usimd/rpi-cm4-homeassistant-base/rpi-cm-ssd.kicad_pcb

## KiCad design rpi-cm-ssd.kicad_pcb (2025-02-02)

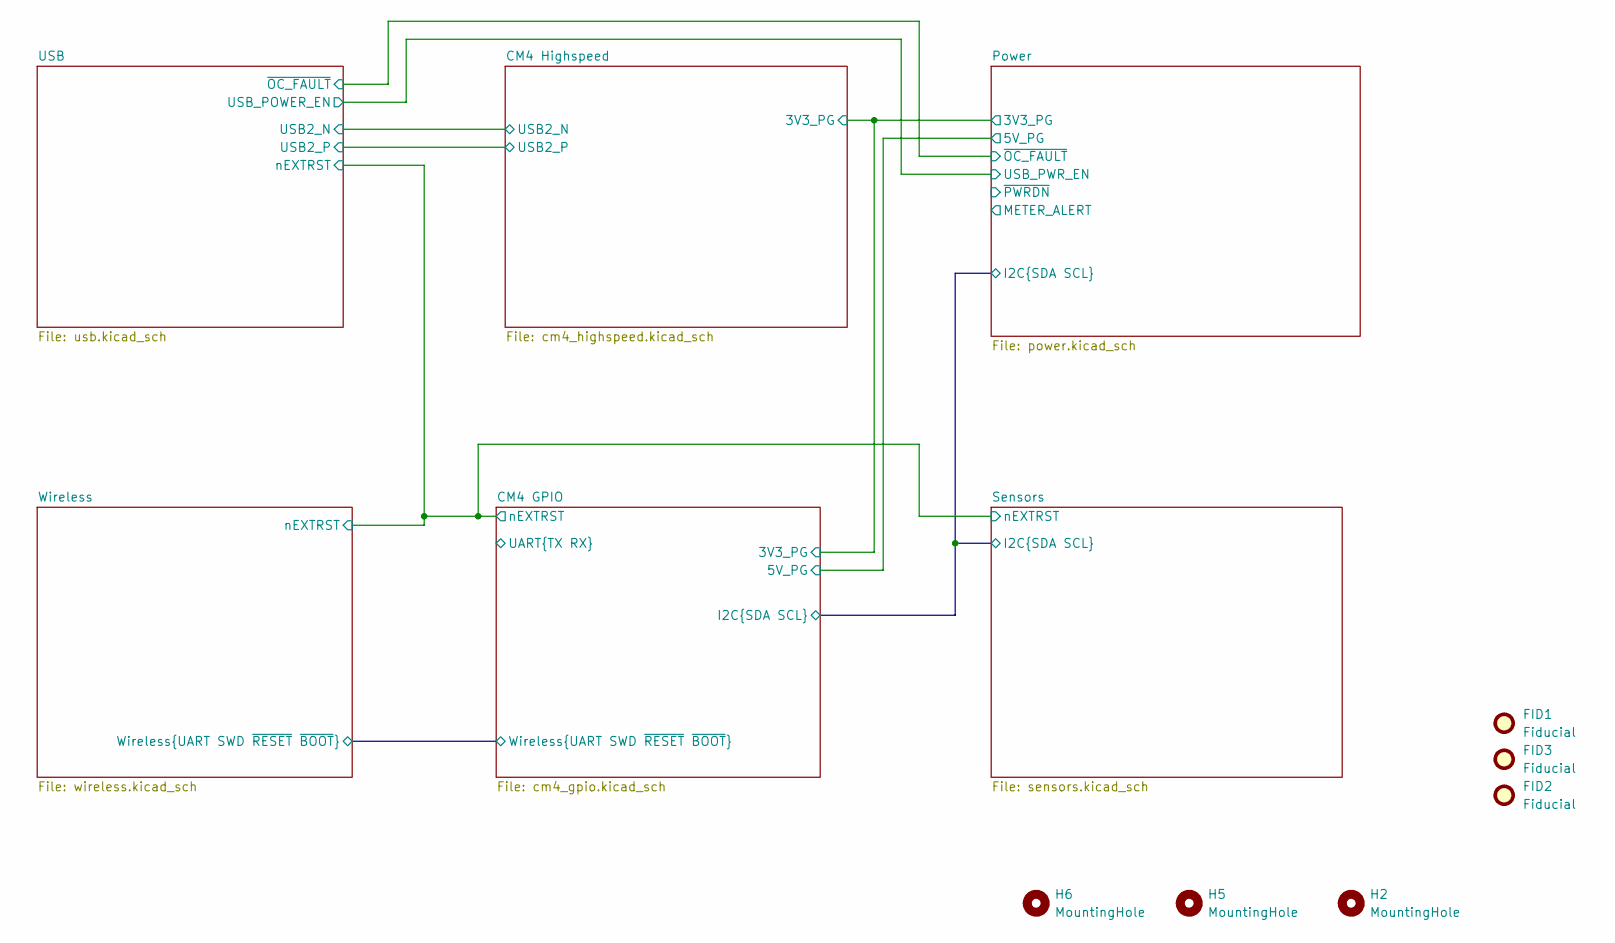
[picture p3: schematic rpi-cm-ssd.kicad_sch, Custom Homeassistant Base]

Parts:
FID1, FID2, FID3: Fiducial; Fiducial_0.5mm_Mask1mm
H2, H5, H6: MountingHole; MountingHole_2.7mm_M2.5; MPN KFS2-M2.5

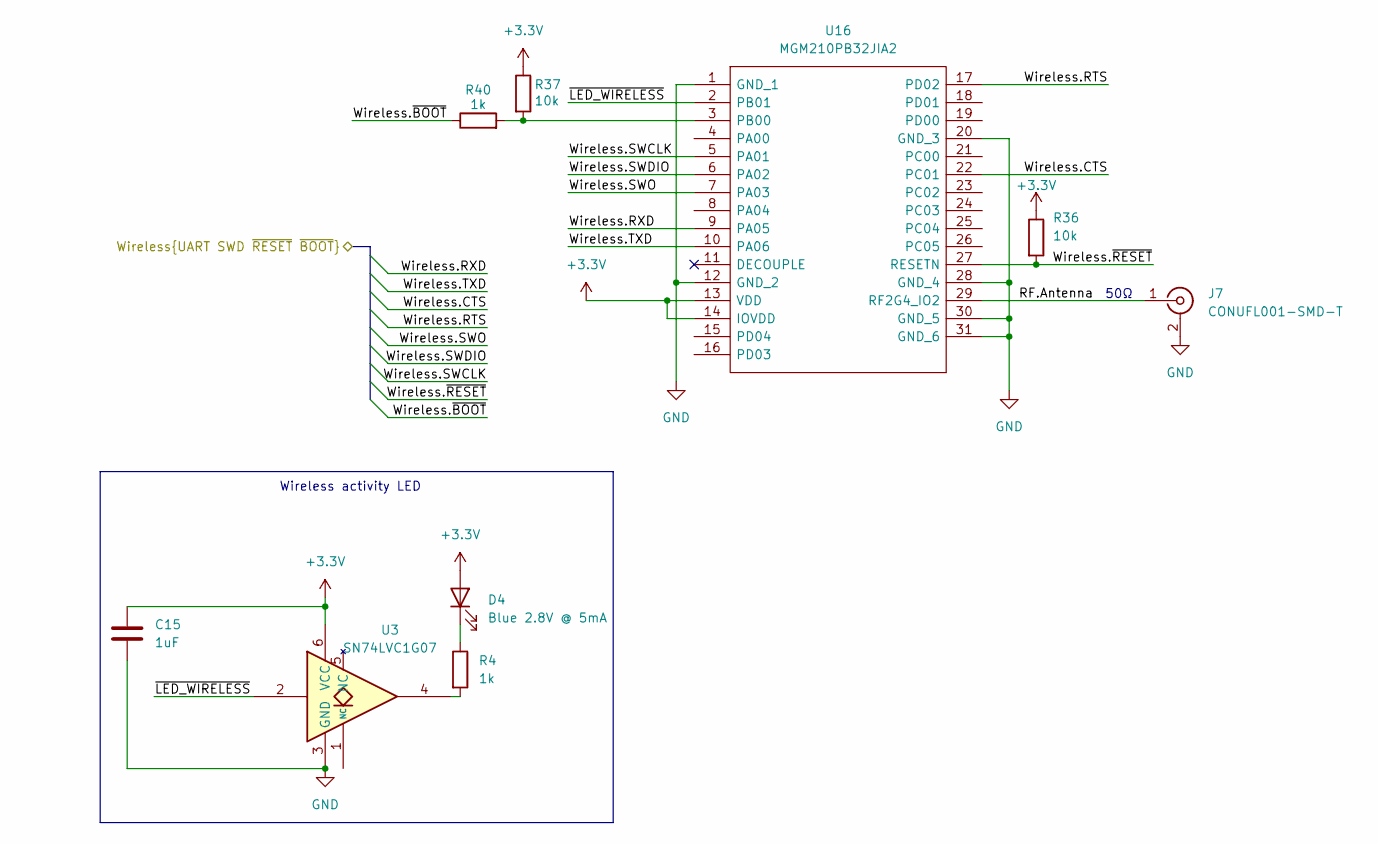
[picture p4: schematic wireless.kicad_sch]

Parts:
C15: 1uF; C_0402_1005Metric
D4: Blue 2.8V @ 5mA; LED_0603_1608Metric; MPN XL-1608UBC-04; LCSC Part # C965807
J7: CONUFL001-SMD-T; U.FL_Hirose_U.FL-R-SMT-1_Vertical; MPN CONUFL001-SMD-T; LCSC Part # C22418213
R4: 1k; R_0402_1005Metric
R36, R37: 10k; R_0603_1608Metric
R40: 1k; R_0603_1608Metric
U3: SN74LVC1G07; Texas_USON-6_1x1.45mm_P0.5mm_SMD; MPN SN74LVC1G07DRY; LCSC Part # C2675513
U16: MGM210PB32JIA2; MGM210PA32JIA2; Manufacturer_Part_Number MGM210PB32JIA2; Mouser Part Number 634-MGM210PB32JIA2

Connections:
+3.3V: C15.1, D4.2 (A), R36.1, R37.1, U3.6 (VCC), U16.13 (VDD), U16.14 (IOVDD); also elsewhere on the board
/CM4 GPIO/Wireless.CTS: U16.22 (PC01); also elsewhere on the board
/CM4 GPIO/Wireless.RTS: U16.17 (PD02); also elsewhere on the board
/CM4 GPIO/Wireless.RXD: U16.9 (PA05); also elsewhere on the board
/CM4 GPIO/Wireless.SWCLK: U16.5 (PA01); also elsewhere on the board
/CM4 GPIO/Wireless.SWDIO: U16.6 (PA02); also elsewhere on the board
/CM4 GPIO/Wireless.SWO: U16.7 (PA03)
/CM4 GPIO/Wireless.TXD: U16.10 (PA06); also elsewhere on the board
/CM4 GPIO/Wireless.~BOOT: R40.1; also elsewhere on the board
/CM4 GPIO/Wireless.~RESET: R36.2, U16.27 (RESETN); also elsewhere on the board
/Wireless/RF.Antenna: J7.1 (In), U16.29 (RF2G4_IO2)
/Wireless/~LED_WIRELESS: U3.2, U16.2 (PB01)
GND: C15.2, J7.2 (Ext), U3.3 (GND), U16.1 (GND_1), U16.12 (GND_2), U16.20 (GND_3), U16.28 (GND_4), U16.30 (GND_5), U16.31 (GND_6); also elsewhere on the board
unnamed: D4.1 (K), R4.1
unnamed: R4.2, U3.4
unnamed: R37.2, R40.2, U16.3 (PB00)

Notes on the sheet:
50Ω
Wireless activity LED

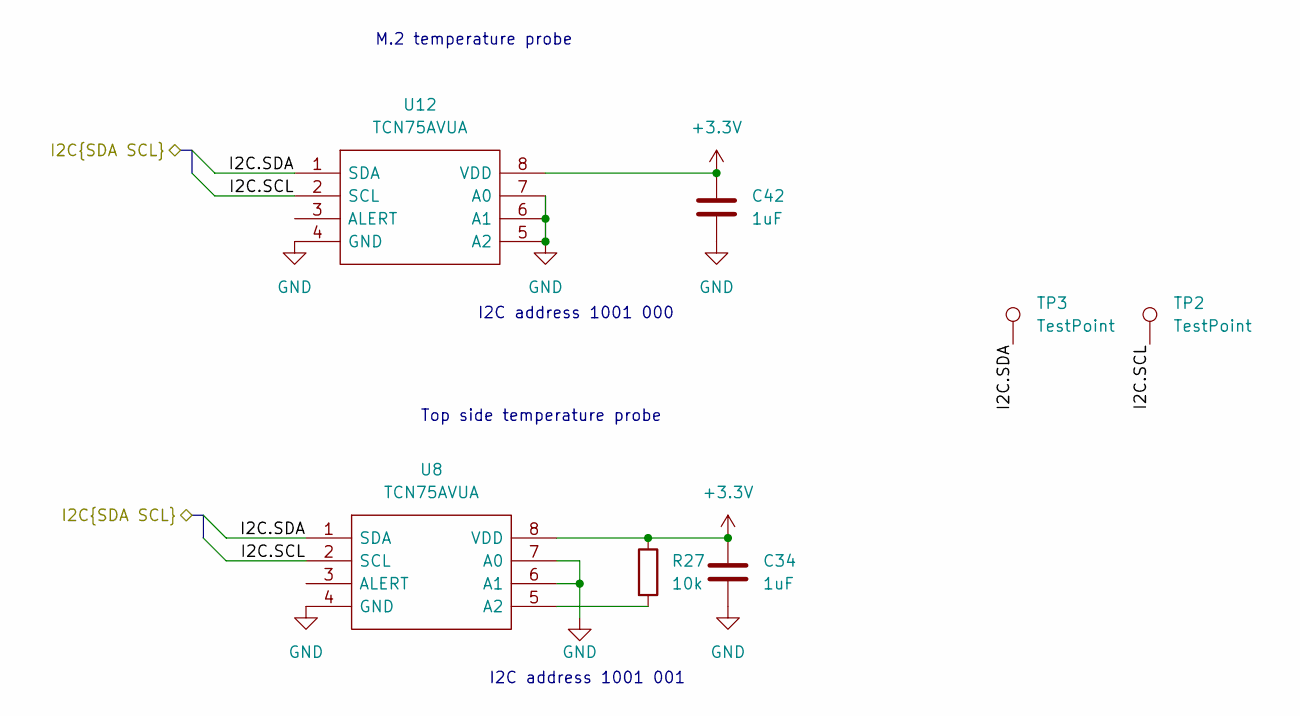
[picture p5: schematic sensors.kicad_sch]

Parts:
C34, C42: 1uF; C_0402_1005Metric; MPN CL05B104KA5NNNC
R27: 10k; R_0402_1005Metric; MPN AC0402FR-0710KL
TP2, TP3: TestPoint; TestPoint_Keystone_5000-5004_Miniature
U8, U12: TCN75AVUA; SOP65P490X110-8N; Manufacturer_Part_Number TCN75AVUA; Mouser Part Number 579-TCN75AVUA

Connections:
+3.3V: C34.2, C42.2, R27.1, U8.8 (VDD), U12.8 (VDD); also elsewhere on the board
/CM4 GPIO/I2C.SCL: TP2.1, U8.2 (SCL), U12.2 (SCL); also elsewhere on the board
/CM4 GPIO/I2C.SDA: TP3.1, U8.1 (SDA), U12.1 (SDA); also elsewhere on the board
GND: C34.1, C42.1, U8.4 (GND), U8.6 (A1), U8.7 (A0), U12.4 (GND), U12.5 (A2), U12.6 (A1), U12.7 (A0); also elsewhere on the board
unnamed: R27.2, U8.5 (A2)

Notes on the sheet:
M.2 temperature probe
I2C address 1001 000
Top side temperature probe
I2C address 1001 001

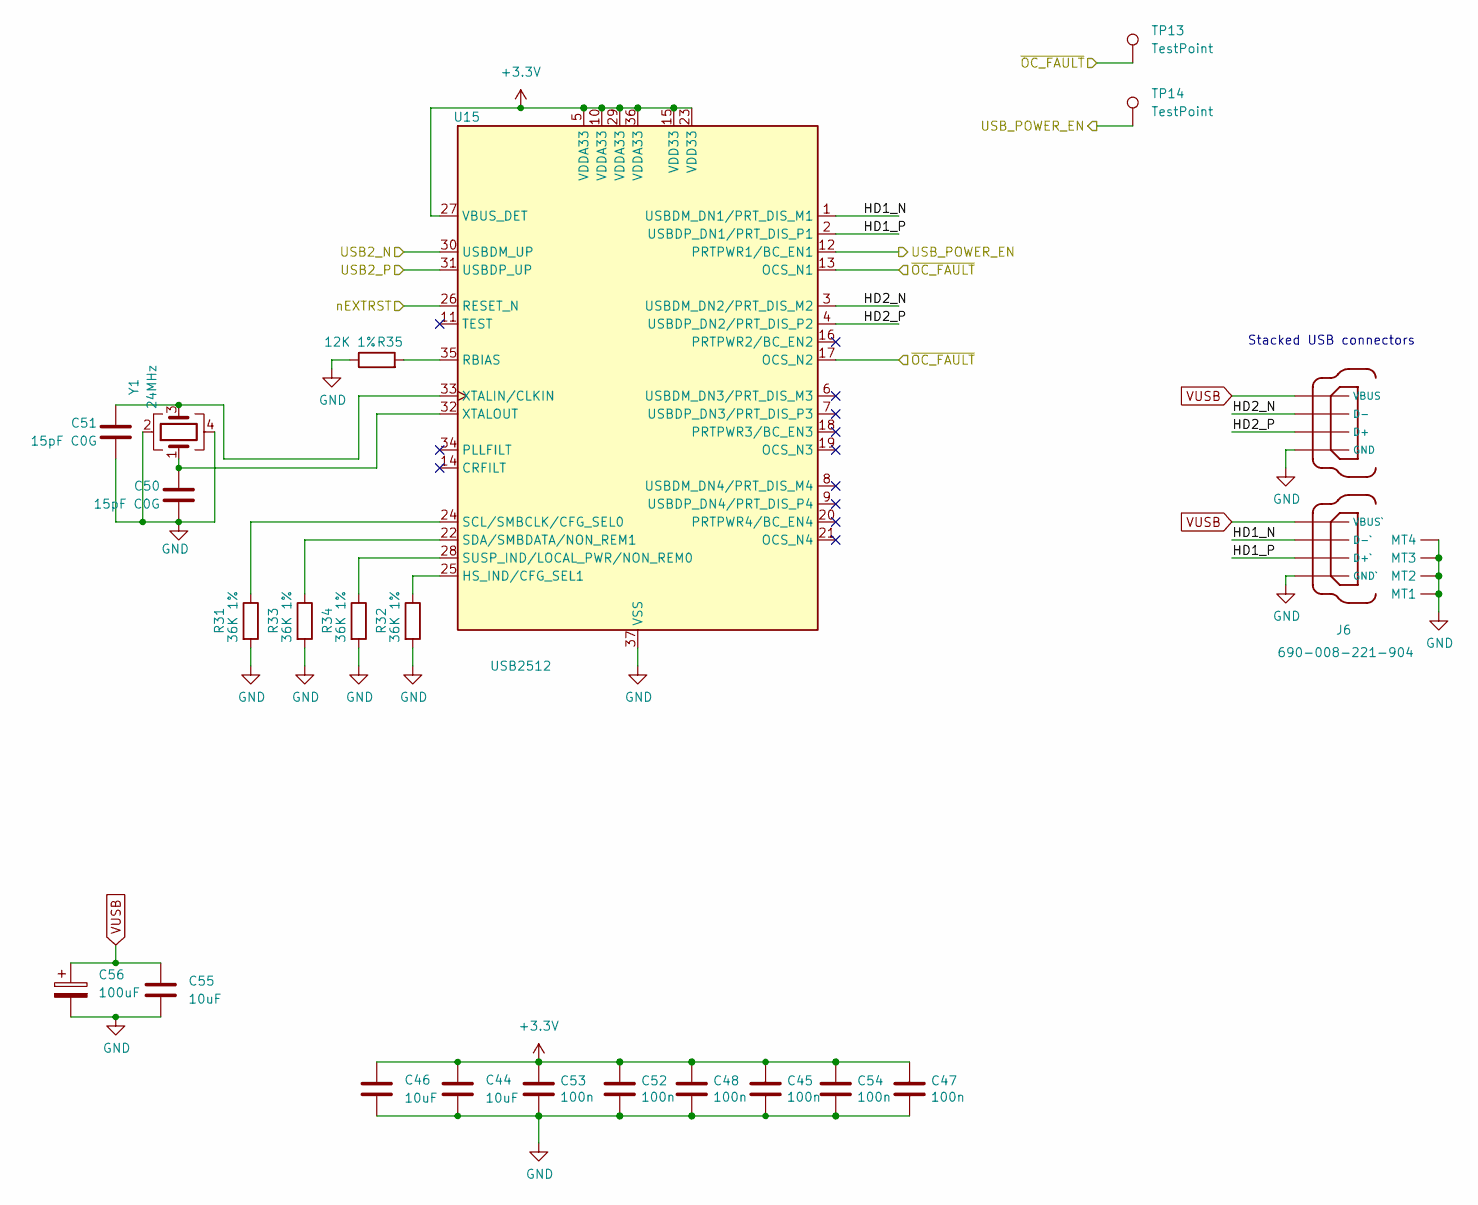
[picture p6: schematic usb.kicad_sch]

Parts:
C44, C46, C55: 10uF; C_0603_1608Metric; MPN GRM188R61E106KA73D
C45, C47, C48, C52, C53, C54: 100n; C_0402_1005Metric; Part Description 0.1uF 10% 16V Ceramic Capacitor X7R 040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
C50, C51: 15pF C0G; C_0402_1005Metric; MPN 04021C150KAT2A
C56: 100uF; CP_EIA-3216-10_Kemet-I
J6: 690-008-221-904; MOLEX_USB_67298-4090; Part Description USB-A (USB TYPE-A), Stacked Receptacle 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
R31, R32, R33, R34: 36K 1%; R_0402_1005Metric; Part Description Resistor 36K M1005 1% 63mW
R35: 12K 1%; R_0402_1005Metric; Part Description Resistor 12K M1005 1% 63mW
TP13, TP14: TestPoint; TestPoint_Keystone_5000-5004_Miniature
U15: USB2512; QFN-36-1EP_6x6mm_P0.5mm_EP3.7x3.7mm; Part Description USB Hub Controller USB Interface 36-SQF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; LCSC Part # C633332
Y1: 24MHz; Crystal_SMD_2520-4Pin_2.5x2.0mm; MPN ECS-240-8-36-RWN-TR3

Connections:
+3.3V: C44.2, C45.1, C46.2, C47.1, C48.1, C52.1, C53.1, C54.1, U15.5 (VDDA33), U15.10 (VDDA33), U15.15 (VDD33), U15.23 (VDD33), U15.27 (VBUS_DET), U15.29 (VDDA33), U15.36 (VDDA33); also elsewhere on the board
/CM4 GPIO/nEXTRST: U15.26 (RESET_N); also elsewhere on the board
/CM4 Highspeed/USB2_N: U15.30 (USBDM_UP); also elsewhere on the board
/CM4 Highspeed/USB2_P: U15.31 (USBDP_UP); also elsewhere on the board
/Power/USB_PWR_EN: TP14.1, U15.12 (PRTPWR1/BC_EN1); also elsewhere on the board
/Power/~OC_FAULT: TP13.1, U15.13 (OCS_N1), U15.17 (OCS_N2); also elsewhere on the board
/USB/HD1_N: J6.2 (D-`), U15.1 (USBDM_DN1/PRT_DIS_M1)
/USB/HD1_P: J6.3 (D+`), U15.2 (USBDP_DN1/PRT_DIS_P1)
/USB/HD2_N: J6.6 (D-), U15.3 (USBDM_DN2/PRT_DIS_M2)
/USB/HD2_P: J6.7 (D+), U15.4 (USBDP_DN2/PRT_DIS_P2)
GND: C44.1, C45.2, C46.1, C47.2, C48.2, C50.1, C51.1, C52.2, C53.2, C54.2, C55.1, C56.2, J6.4 (GND`), J6.8 (GND), J6.MT1, J6.MT2, J6.MT3, J6.MT4, R31.2, R32.2, R33.2, R34.2, R35.1, U15.37 (VSS), Y1.2, Y1.4; also elsewhere on the board
unnamed: R32.1, U15.25 (HS_IND/CFG_SEL1)
unnamed: R35.2, U15.35 (RBIAS)
unnamed: R31.1, U15.24 (SCL/SMBCLK/CFG_SEL0)
unnamed: R33.1, U15.22 (SDA/SMBDATA/NON_REM1)
unnamed: R34.1, U15.28 (SUSP_IND/LOCAL_PWR/NON_REM0)
unnamed: C51.2, U15.33 (XTALIN/CLKIN), Y1.3
unnamed: C50.2, U15.32 (XTALOUT), Y1.1
VUSB: C55.2, C56.1, J6.1 (VBUS`), J6.5 (VBUS); also elsewhere on the board

Notes on the sheet:
Stacked USB connectors

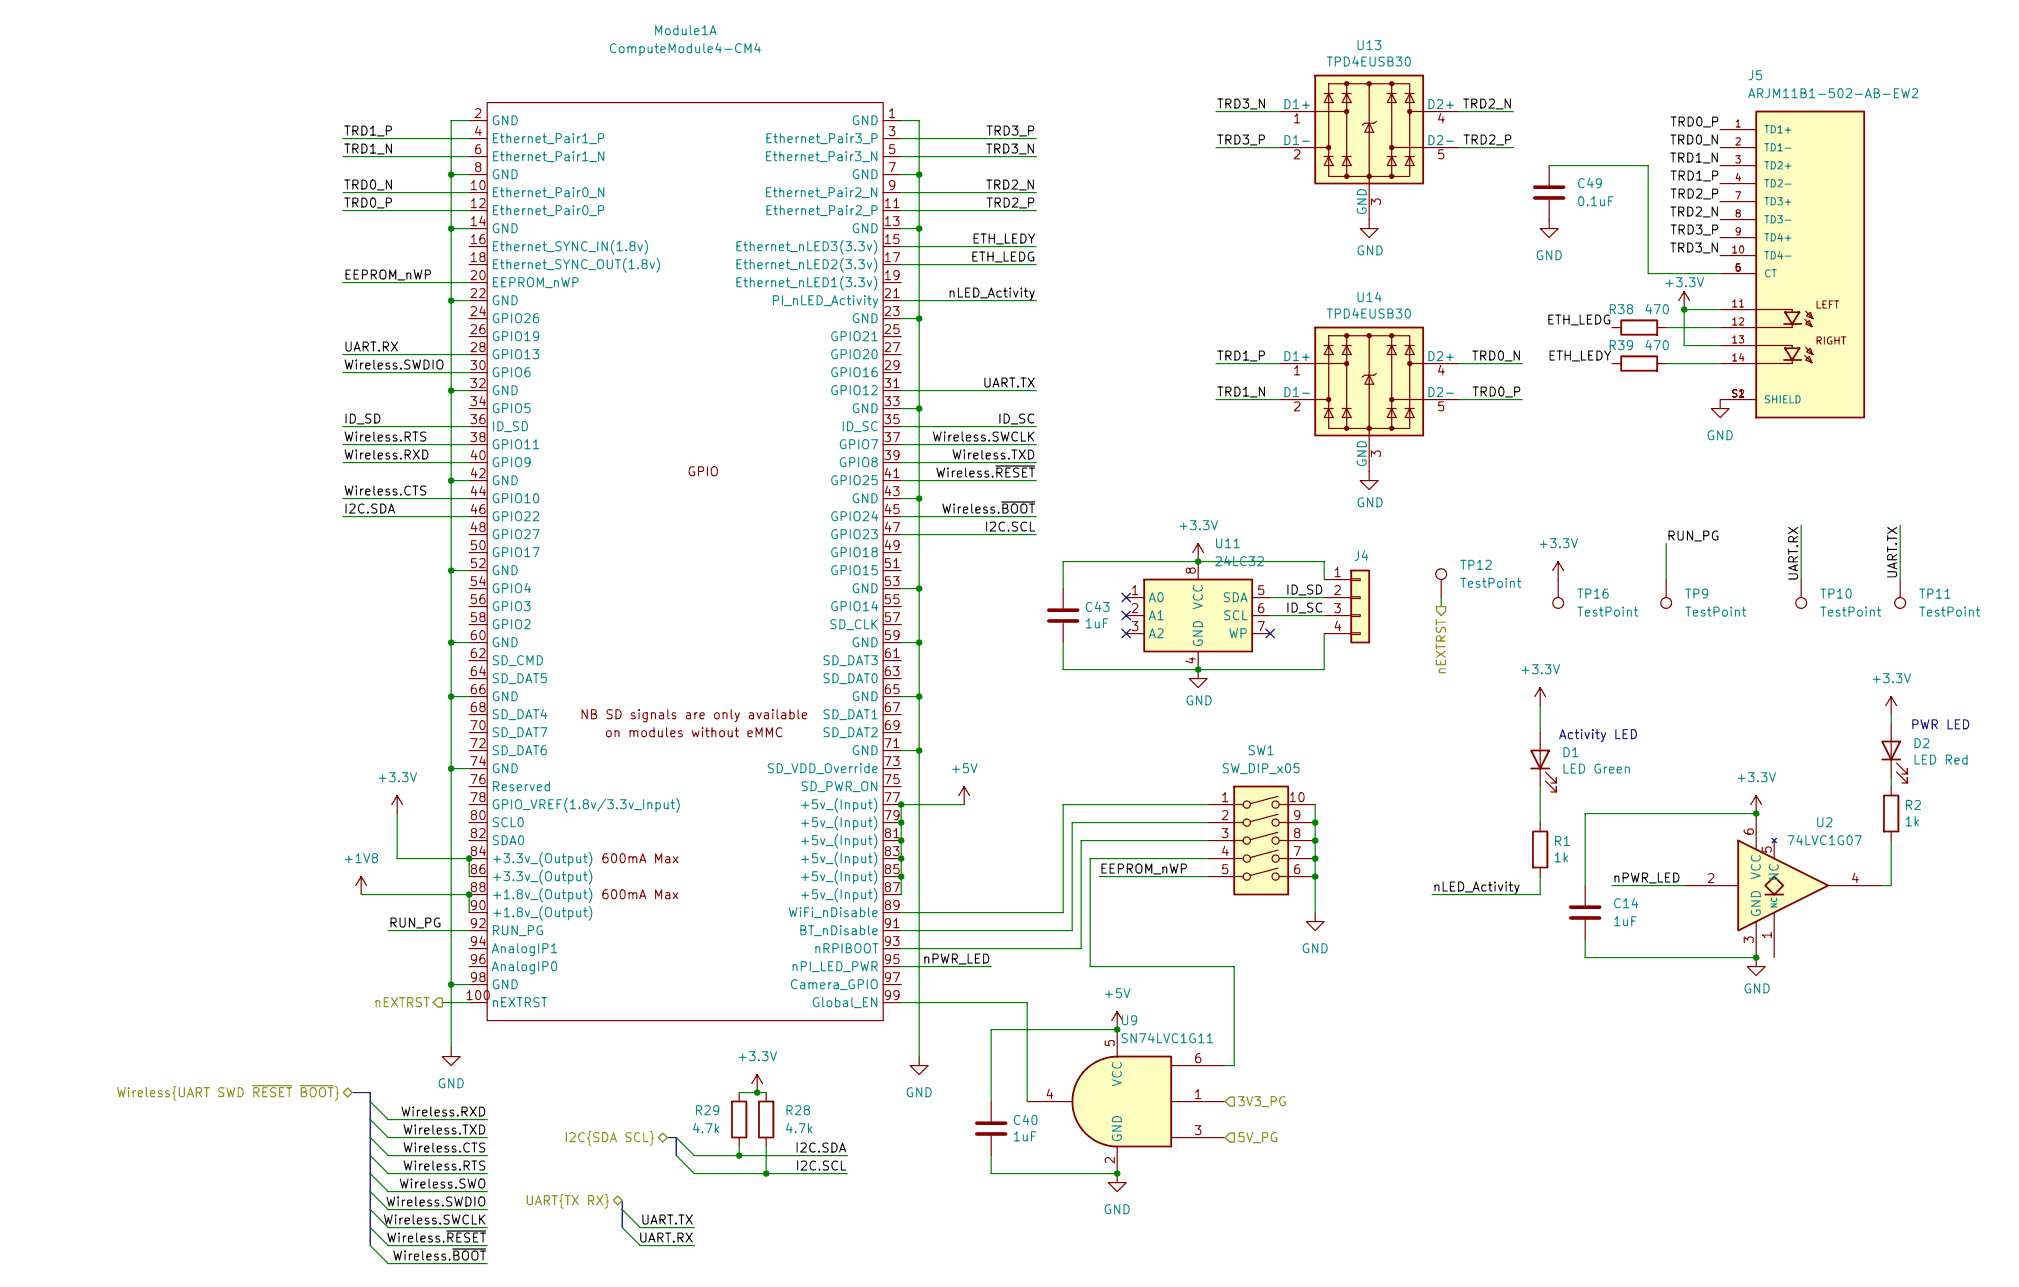
[picture p7: schematic cm4_gpio.kicad_sch]

Parts:
C14: 1uF; C_0402_1005Metric
C40: 1uF; C_0603_1608Metric; Part Description 0.1uF 10% 16V Ceramic Capacitor X7R 040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
C43: 1uF; C_0402_1005Metric; Part Description 0.1uF 10% 16V Ceramic Capacitor X7R 040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
C49: 0.1uF; C_0402_1005Metric; MPN CL05B104KA5NNNC
D1: LED Green; LED_0603_1608Metric; Part Description Green 572nm LED Indication - Discrete 2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; Digi-Key_PN 160-1478-1-ND
D2: LED Red; LED_0603_1608Metric; Part Description Red 620nm LED Indication - Discrete 2.2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; Digi-Key_PN 160-1479-1-ND
J4: PinHeader_1x04_P2.54mm_Vertical_SMD_Pin1Left
J5: ARJM11B1-502-AB-EW2; ABRACON_ARJM11B1-502-AB-EW2; PARTREV 01-21-20
Module1: ComputeModule4-CM4; Raspberry-Pi-4-Compute-Module; MPN DF40C-100DS-0.4V
R1, R2: 1k; R_0402_1005Metric; MPN RC0603FR-071KL; Digi-Key_PN 311-1.00KHRCT-ND
R28, R29: 4.7k; R_0402_1005Metric; MPN RC0402FR-7D4K7L
R38, R39: 470; R_0402_1005Metric; MPN RC0402FR-07470RL
SW1: SW_DIP_x05; SW_DIP_SPSTx05_Slide_KingTek_DSHP05TJ_W5.25mm_P1.27mm_JPin
TP9, TP10, TP11, TP12: TestPoint; TestPoint_Keystone_5000-5004_Miniature
TP16: TestPoint; TestPoint_Pad_D1.0mm
U2: 74LVC1G07; Texas_USON-6_1x1.45mm_P0.5mm_SMD; MPN SN74LVC1G07DRY; LCSC Part # C2675513
U9: SN74LVC1G11; Texas_USON-6_1x1.45mm_P0.5mm_SMD; MPN SN74LVC1G11DRYR
U11: 24LC32; SOIC-8_3.9x4.9mm_P1.27mm; MPN 24LC32A/SN; LCSC Part # C615215
U13, U14: TPD4EUSB30; USON-10_2.5x1.0mm_P0.5mm; Part Description Quad TVS diode for high speed signals (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; LCSC Part # C90627

Connections:
+1V8: Module1.88 (+1.8v_(Output)), Module1.90 (+1.8v_(Output))
+3.3V: C14.1, C43.1, D1.2 (A), D2.2 (A), J4.1, J5.11, J5.13, Module1.84 (+3.3v_(Output)), Module1.86 (+3.3v_(Output)), R28.2, R29.2, TP16.1, U2.6 (VCC), U11.8 (VCC); also elsewhere on the board
+5V: C40.1, Module1.77 (+5v_(Input)), Module1.79 (+5v_(Input)), Module1.81 (+5v_(Input)), Module1.83 (+5v_(Input)), Module1.85 (+5v_(Input)), Module1.87 (+5v_(Input)), U9.5 (VCC); also elsewhere on the board
/CM4 GPIO/3V3_PG: U9.1; also elsewhere on the board
/CM4 GPIO/5V_PG: U9.3; also elsewhere on the board
/CM4 GPIO/EEPROM_nWP: Module1.20 (EEPROM_nWP), SW1.5
/CM4 GPIO/ETH_LEDG: Module1.17 (Ethernet_nLED2(3.3v)), R38.1
/CM4 GPIO/ETH_LEDY: Module1.15 (Ethernet_nLED3(3.3v)), R39.1
/CM4 GPIO/I2C.SCL: Module1.47 (GPIO23), R28.1; also elsewhere on the board
/CM4 GPIO/I2C.SDA: Module1.46 (GPIO22), R29.1; also elsewhere on the board
/CM4 GPIO/ID_SC: J4.3, Module1.35 (ID_SC), U11.6 (SCL)
/CM4 GPIO/ID_SD: J4.2, Module1.36 (ID_SD), U11.5 (SDA)
/CM4 GPIO/RUN_PG: Module1.92 (RUN_PG), TP9.1
/CM4 GPIO/TRD0_N: J5.2 (TD1-), Module1.10 (Ethernet_Pair0_N), U14.4 (D2+), U14.7
/CM4 GPIO/TRD0_P: J5.1 (TD1+), Module1.12 (Ethernet_Pair0_P), U14.5 (D2-), U14.6
/CM4 GPIO/TRD1_N: J5.3 (TD2+), Module1.6 (Ethernet_Pair1_N), U14.2 (D1-), U14.9
/CM4 GPIO/TRD1_P: J5.4 (TD2-), Module1.4 (Ethernet_Pair1_P), U14.1 (D1+), U14.10
/CM4 GPIO/TRD2_N: J5.8 (TD3-), Module1.9 (Ethernet_Pair2_N), U13.4 (D2+), U13.7
/CM4 GPIO/TRD2_P: J5.7 (TD3+), Module1.11 (Ethernet_Pair2_P), U13.5 (D2-), U13.6
/CM4 GPIO/TRD3_N: J5.10 (TD4-), Module1.5 (Ethernet_Pair3_N), U13.1 (D1+), U13.10
/CM4 GPIO/TRD3_P: J5.9 (TD4+), Module1.3 (Ethernet_Pair3_P), U13.2 (D1-), U13.9
/CM4 GPIO/UART.RX: Module1.28 (GPIO13), TP10.1
/CM4 GPIO/UART.TX: Module1.31 (GPIO12), TP11.1
/CM4 GPIO/Wireless.CTS: Module1.44 (GPIO10); also elsewhere on the board
/CM4 GPIO/Wireless.RTS: Module1.38 (GPIO11); also elsewhere on the board
/CM4 GPIO/Wireless.RXD: Module1.40 (GPIO9); also elsewhere on the board
/CM4 GPIO/Wireless.SWCLK: Module1.37 (GPIO7); also elsewhere on the board
/CM4 GPIO/Wireless.SWDIO: Module1.30 (GPIO6); also elsewhere on the board
/CM4 GPIO/Wireless.TXD: Module1.39 (GPIO8); also elsewhere on the board
/CM4 GPIO/Wireless.~BOOT: Module1.45 (GPIO24); also elsewhere on the board
/CM4 GPIO/Wireless.~RESET: Module1.41 (GPIO25); also elsewhere on the board
/CM4 GPIO/nEXTRST: Module1.100 (nEXTRST), TP12.1; also elsewhere on the board
/CM4 GPIO/nLED_Activity: Module1.21 (PI_nLED_Activity), R1.2
/CM4 GPIO/nPWR_LED: Module1.95 (nPI_LED_PWR), U2.2
GND: C14.2, C40.2, C43.2, C49.2, J4.4, J5.S1 (SHIELD), J5.S2 (SHIELD), Module1.1 (GND), Module1.2 (GND), Module1.7 (GND), Module1.8 (GND), Module1.13 (GND), Module1.14 (GND), Module1.22 (GND), Module1.23 (GND), Module1.32 (GND), Module1.33 (GND), Module1.42 (GND), Module1.43 (GND), Module1.52 (GND), Module1.53 (GND), Module1.59 (GND), Module1.60 (GND), Module1.65 (GND), Module1.66 (GND), Module1.71 (GND), Module1.74 (GND), Module1.98 (GND), SW1.6, SW1.7, SW1.8, SW1.9, SW1.10, U2.3 (GND), U9.2 (GND), U11.4 (GND), U13.3 (GND), U13.8 (GND), U14.3 (GND), U14.8 (GND); also elsewhere on the board
unnamed: C49.1, J5.5 (CT), J5.6 (CT)
unnamed: D1.1 (K), R1.1
unnamed: D2.1 (K), R2.1
unnamed: J5.12, R38.2
unnamed: J5.14, R39.2
unnamed: Module1.91 (BT_nDisable), SW1.2
unnamed: Module1.99 (Global_EN), U9.4
unnamed: Module1.89 (WiFi_nDisable), SW1.1
unnamed: Module1.93 (nRPIBOOT), SW1.3
unnamed: R2.2, U2.4
unnamed: SW1.4, U9.6

Notes on the sheet:
PWR LED
Activity LED

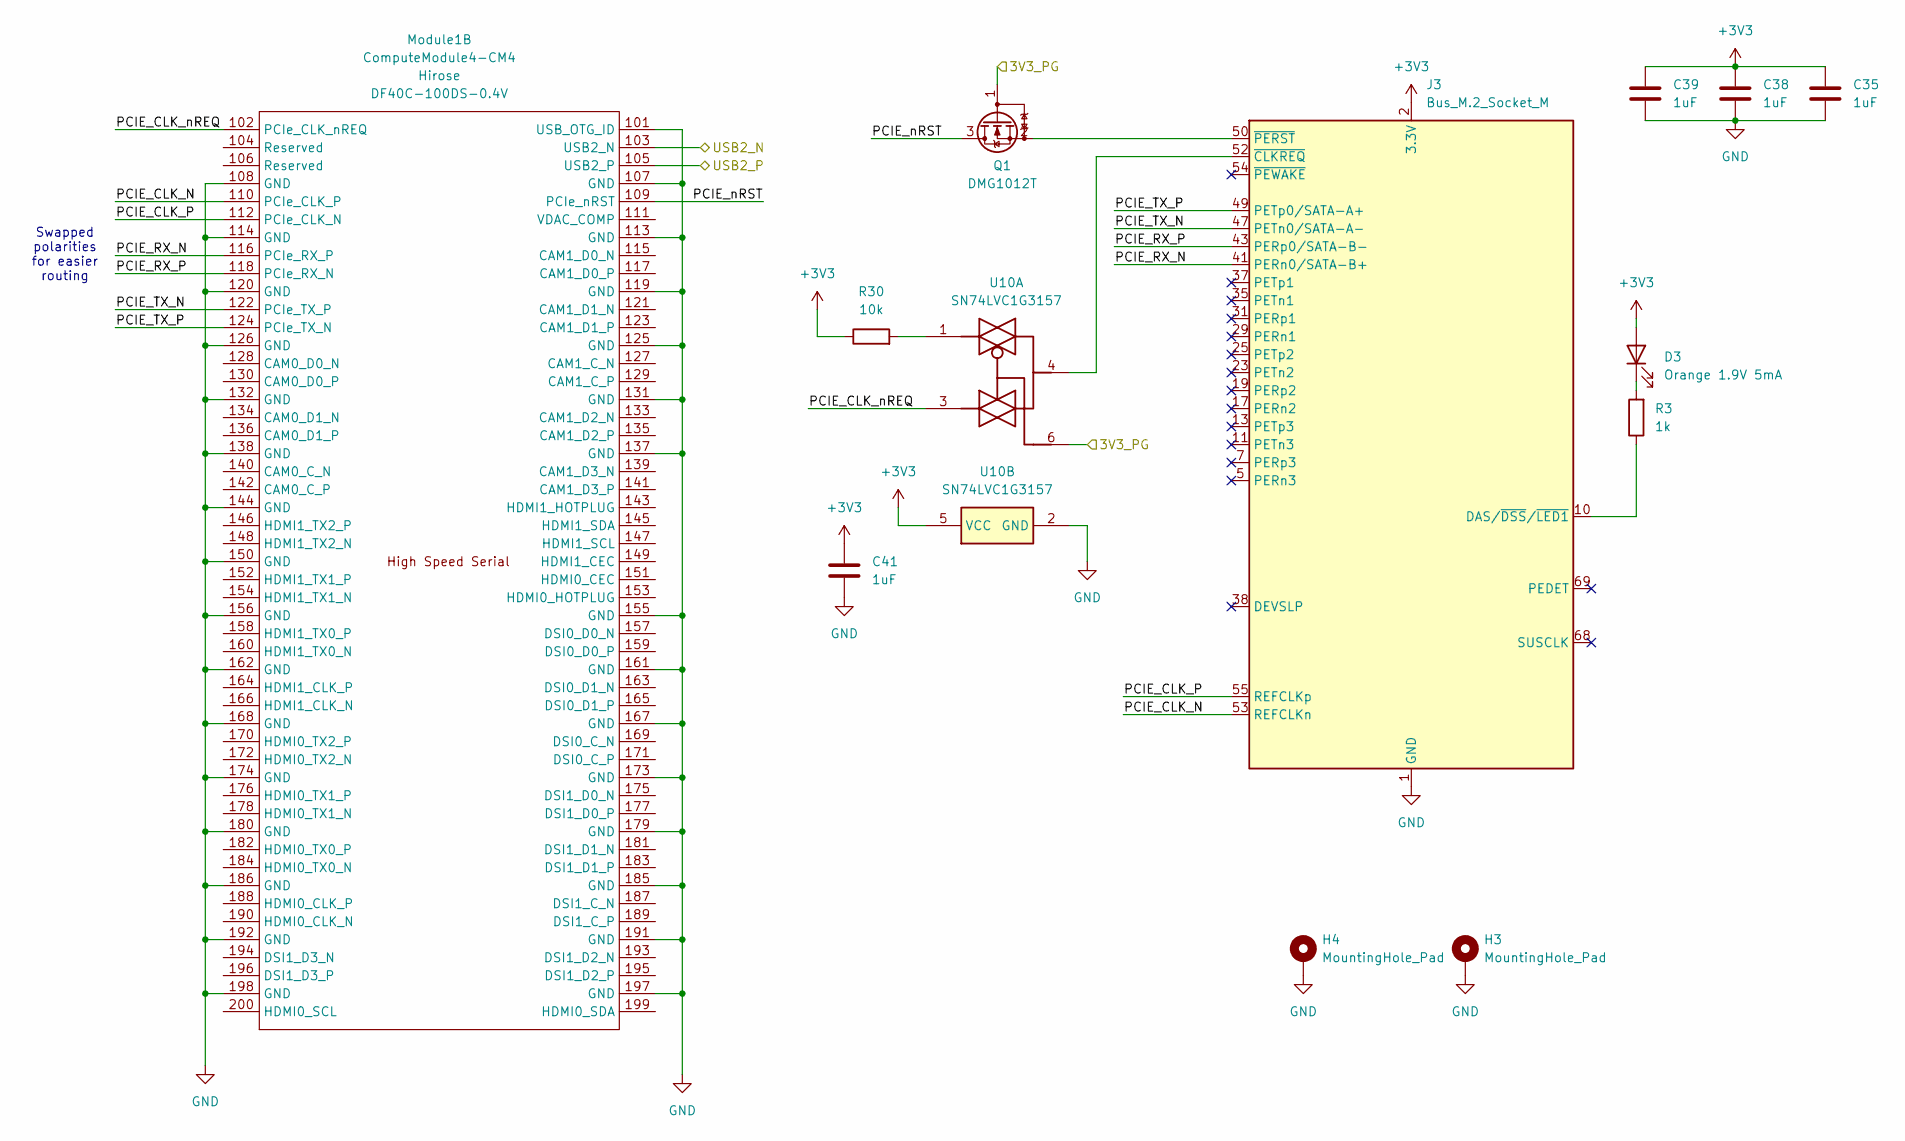
[picture p8: schematic cm4_highspeed.kicad_sch, M.2 socket]

Parts:
C35, C38, C39, C41: 1uF; C_0402_1005Metric
D3: Orange 1.9V 5mA; LED_0603_1608Metric; MPN HSMD-C190; LCSC Part # C18198804
H3, H4: MountingHole_Pad; MountingHole_3.7mm_Pad_TopOnly; MPN 9774015151R
J3: Bus_M.2_Socket_M; JAE_SM3ZS067U310AMR1200; MPN SM3ZS067U310AMR1200; LCSC Part # C4527433
Module1: ComputeModule4-CM4; Raspberry-Pi-4-Compute-Module; MPN DF40C-100DS-0.4V
Q1: DMG1012T; SOT-523; MPN DMG1012T-13; LCSC Part # C42412320
R3: 1k; R_0402_1005Metric
R30: 10k; R_0603_1608Metric
U10: SN74LVC1G3157; SOT-363_SC-70-6; MPN SN74LVC1G3157DRYR; LCSC Part # C2870968

Connections:
+3V3: C35.1, C38.1, C39.1, C41.1, D3.2 (A), J3.2 (3.3V), J3.4 (3.3V), J3.12 (3.3V), J3.14 (3.3V), J3.16 (3.3V), J3.18 (3.3V), J3.70 (3.3V), J3.72 (3.3V), J3.74 (3.3V), R30.1, U10.5 (VCC); also elsewhere on the board
/CM4 GPIO/3V3_PG: Q1.1 (G), U10.6; also elsewhere on the board
/CM4 Highspeed/PCIE_CLK_N: J3.53 (REFCLKn), Module1.110 (PCIe_CLK_P)
/CM4 Highspeed/PCIE_CLK_P: J3.55 (REFCLKp), Module1.112 (PCIe_CLK_N)
/CM4 Highspeed/PCIE_CLK_nREQ: Module1.102 (PCIe_CLK_nREQ), U10.3
/CM4 Highspeed/PCIE_RX_N: J3.41 (PERn0/SATA-B+), Module1.116 (PCIe_RX_P)
/CM4 Highspeed/PCIE_RX_P: J3.43 (PERp0/SATA-B-), Module1.118 (PCIe_RX_N)
/CM4 Highspeed/PCIE_TX_N: J3.47 (PETn0/SATA-A-), Module1.122 (PCIe_TX_P)
/CM4 Highspeed/PCIE_TX_P: J3.49 (PETp0/SATA-A+), Module1.124 (PCIe_TX_N)
/CM4 Highspeed/PCIE_nRST: Module1.109 (PCIe_nRST), Q1.3 (D)
/CM4 Highspeed/USB2_N: Module1.103 (USB2_N); also elsewhere on the board
/CM4 Highspeed/USB2_P: Module1.105 (USB2_P); also elsewhere on the board
GND: C35.2, C38.2, C39.2, C41.2, H3.1, H4.1, J3.1 (GND), J3.3 (GND), J3.9 (GND), J3.15 (GND), J3.21 (GND), J3.27 (GND), J3.33 (GND), J3.39 (GND), J3.45 (GND), J3.51 (GND), J3.57 (GND), J3.71 (GND), J3.73 (GND), J3.75 (GND), Module1.101 (USB_OTG_ID), Module1.107 (GND), Module1.108 (GND), Module1.113 (GND), Module1.114 (GND), Module1.119 (GND), Module1.120 (GND), Module1.125 (GND), Module1.126 (GND), Module1.131 (GND), Module1.132 (GND), Module1.137 (GND), Module1.138 (GND), Module1.144 (GND), Module1.150 (GND), Module1.155 (GND), Module1.156 (GND), Module1.161 (GND), Module1.162 (GND), Module1.167 (GND), Module1.168 (GND), Module1.173 (GND), Module1.174 (GND), Module1.179 (GND), Module1.180 (GND), Module1.185 (GND), Module1.186 (GND), Module1.191 (GND), Module1.192 (GND), Module1.197 (GND), Module1.198 (GND), U10.2 (GND); also elsewhere on the board
unnamed: D3.1 (K), R3.2
unnamed: J3.10 (DAS/~DSS/~LED1), R3.1
unnamed: J3.52 (~CLKREQ), U10.4
unnamed: J3.50 (~PERST), Q1.2 (S)
unnamed: R30.2, U10.1

Notes on the sheet:
Swapped polarities for easier routing
