usimd/rpi-cm4-homeassistant-base/rpi-cm-ssd.kicad_pcb

## KiCad design rpi-cm-ssd.kicad_pcb (continued)

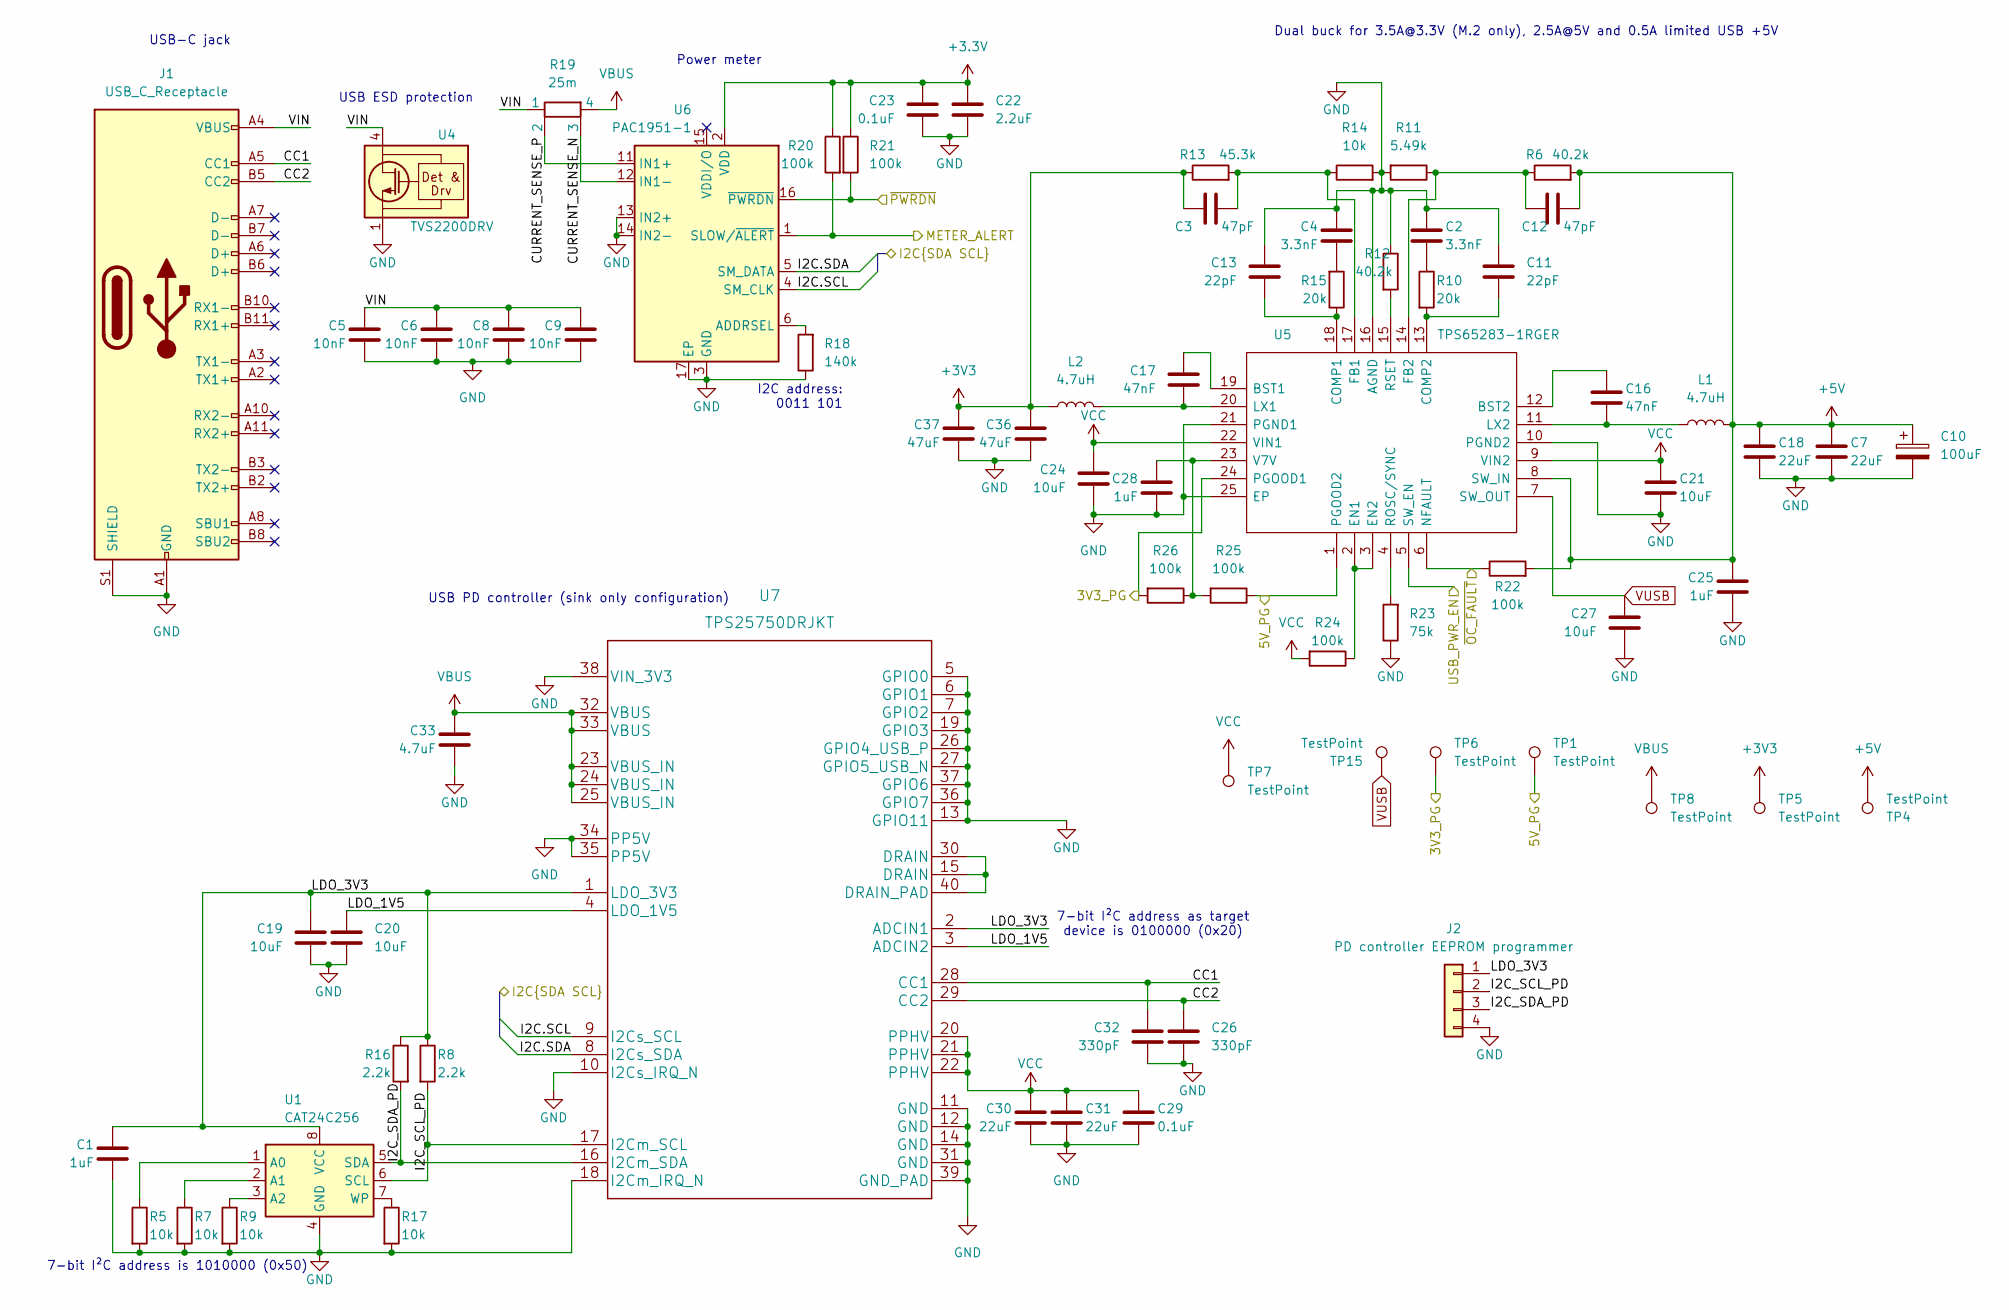
[picture p9: schematic power.kicad_sch]

Parts:
C1: 1uF; C_0402_1005Metric; MPN CL05B104KA5NNNC
C2, C4: 3.3nF; C_0402_1005Metric; MPN CC0402JRX7R9BB332
C3, C12: 47pF; C_0402_1005Metric; MPN C0402C470J5RACAUTO
C5, C6, C8, C9: 10nF; C_0402_1005Metric; MPN CC0402JRX7R9BB103
C7, C18: 22uF; C_0805_2012Metric; MPN CL21A226KOQNNNE
C10: 100uF; CP_EIA-3216-10_Kemet-I
C11, C13: 22pF; C_0402_1005Metric; MPN C0402C220K5RACTU
C16, C17: 47nF; C_0402_1005Metric; MPN UMK105B7472KV-F
C19, C20, C21, C24, C27: 10uF; C_0603_1608Metric; MPN GRM188R61E106KA73D
C22: 2.2uF; C_0402_1005Metric; MPN LMK105BJ225KV-F
C23: 0.1uF; C_0402_1005Metric; MPN CL05B104KA5NNNC
C25, C28: 1uF; C_0402_1005Metric; MPN GRM155R61E105KA12J
C26, C32: 330pF; C_0402_1005Metric; MPN 885012205058
C29: 0.1uF; C_1206_3216Metric; MPN CL05B104KA5NNNC
C30, C31: 22uF; C_1206_3216Metric; MPN CL31A226KAHNNNE
C33: 4.7uF; C_0603_1608Metric; MPN GRM188R6YA475KE15D
C36, C37: 47uF; C_0805_2012Metric; MPN CL21A226KOQNNNE
J1: USB_C_Receptacle; USB_C_Receptacle_Amphenol_12401610E4-2A; MPN 12401610E4#2A; LCSC Part # C5119948
J2: PD controller EEPROM programmer; PinHeader_1x04_P2.54mm_Vertical_SMD_Pin1Left
L1, L2: 4.7uH; L_Coilcraft_XAL60xx_6.36x6.56mm; MPN XAL6060-472MEC; LCSC Part # C3040367
R5, R7, R9, R14, R17: 10k; R_0402_1005Metric; MPN AC0402FR-0710KL
R6: 40.2k; R_0402_1005Metric; MPN RC0402FR-0740K2L
R8, R16: 2.2k; R_0402_1005Metric; MPN RC0402FR-132K2L
R10, R15: 20k; R_0402_1005Metric; MPN RC0402FR-1320KL
R11: 5.49k; R_0402_1005Metric; MPN RC0402FR-075K49L
R12: 40.2k; R_0402_1005Metric; MPN RC0402FR-0716K9L
R13: 45.3k; R_0402_1005Metric; MPN AC0402FR-0745K3L
R18: 140k; R_0402_1005Metric; MPN RC0402FR-07470RL
R19: 25m; R_Shunt_Vishay_WSK2512_6332Metric_T1.19mm; MPN WSK2512R0250DEA
R20: 100k; R_0402_1005Metric
R21: 100k; R_0805_2012Metric
R22, R24, R25, R26: 100k; R_0402_1005Metric; MPN RC0402FR-07100KL
R23: 75k; R_0402_1005Metric; MPN RC0402FR-07100KL
TP1, TP5, TP6, TP15: TestPoint; TestPoint_Keystone_5000-5004_Miniature
TP4, TP7, TP8: TestPoint; TestPoint_Pad_D1.0mm
U1: CAT24C256; SOIC-8_3.9x4.9mm_P1.27mm; MPN CAT24C256WI-GT3; LCSC Part # C36533643
U4: TVS2200DRV; WSON-6-1EP_2x2mm_P0.65mm_EP1x1.6mm; MPN TVS2200DRVR; LCSC Part # C523793
U5: TPS65283-1RGER; QFN50P400X400X100-25N-D; Manufacturer_Part_Number TPS65283-1RGER; Mouser Part Number 595-TPS65283-1RGER
U6: PAC1951-1; VQFN-16-1EP_3x3mm_P0.5mm_EP1.1x1.1mm_ThermalVias; MPN PAC1951T-1E/4MX; LCSC Part # C5226663
U7: TPS25750DRJKT; PTPS25750DRJKT; MPN TPS25750DRJKT; LCSC Part # C2868209

Connections:
+3.3V: C22.2, C23.1, R20.1, R21.1, U6.2 (VDD); also elsewhere on the board
+3V3: C3.1, C36.2, C37.2, L2.1, R13.1, TP5.1; also elsewhere on the board
+5V: C7.2, C10.1, C12.1, C18.2, C25.2, L1.2, R6.2, R22.2, TP4.1, U5.8 (SW_IN); also elsewhere on the board
/CM4 GPIO/3V3_PG: R26.2, TP6.1, U5.24 (PGOOD1); also elsewhere on the board
/CM4 GPIO/5V_PG: R25.1, TP1.1, U5.1 (PGOOD2); also elsewhere on the board
/CM4 GPIO/I2C.SCL: U6.4 (SM_CLK), U7.9 (I2Cs_SCL); also elsewhere on the board
/CM4 GPIO/I2C.SDA: U6.5 (SM_DATA), U7.8 (I2Cs_SDA); also elsewhere on the board
/Power/CC1: C32.2, J1.A5 (CC1), U7.28 (CC1)
/Power/CC2: C26.1, J1.B5 (CC2), U7.29 (CC2)
/Power/CURRENT_SENSE_N: R19.3, U6.12 (IN1-)
/Power/CURRENT_SENSE_P: R19.2, U6.11 (IN1+)
/Power/I2C_SCL_PD: J2.2, R8.2, U1.6 (SCL), U7.17 (I2Cm_SCL)
/Power/I2C_SDA_PD: J2.3, R16.2, U1.5 (SDA), U7.16 (I2Cm_SDA)
/Power/LDO_1V5: C20.1, U7.3 (ADCIN2), U7.4 (LDO_1V5)
/Power/LDO_3V3: C1.2, C19.2, J2.1, R8.1, R16.1, U1.8 (VCC), U7.1 (LDO_3V3), U7.2 (ADCIN1)
/Power/METER_ALERT: R20.2, U6.1 (SLOW/~ALERT)
/Power/USB_PWR_EN: U5.5 (SW_EN); also elsewhere on the board
/Power/VIN: C5.1, C6.1, C8.1, C9.1, J1.A4 (VBUS), J1.A9 (VBUS), J1.B4 (VBUS), J1.B9 (VBUS), R19.1, U4.4 (IN), U4.5 (IN), U4.6 (IN)
/Power/~OC_FAULT: R22.1, U5.6 (NFAULT); also elsewhere on the board
/Power/~PWRDN: R21.2, U6.16 (~PWRDN)
GND: C1.1, C2.1, C4.2, C5.2, C6.2, C7.1, C8.2, C9.2, C10.2, C11.2, C13.2, C18.1, C19.1, C20.2, C21.1, C22.1, C23.2, C24.1, C25.1, C26.2, C27.1, C28.1, C29.1, C30.1, C31.1, C32.1, C33.1, C36.1, C37.1, J1.A1 (GND), J1.A12 (GND), J1.B1 (GND), J1.B12 (GND), J1.S1 (SHIELD), J2.4, R5.2, R7.2, R9.2, R11.2, R12.1, R14.2, R17.2, R18.1, R23.1, U1.4 (GND), U4.1 (GND), U4.2 (GND), U4.3 (GND), U4.7 (GND), U5.10 (PGND2), U5.16 (AGND), U5.21 (PGND1), U5.25 (EP), U6.3 (GND), U6.7 (GND), U6.8 (GND), U6.9 (GND), U6.10 (GND), U6.13 (IN2+), U6.14 (IN2-), U6.17 (EP), U7.5 (GPIO0), U7.6 (GPIO1), U7.7 (GPIO2), U7.10 (I2Cs_IRQ_N), U7.11 (GND), U7.12 (GND), U7.13 (GPIO11), U7.14 (GND), U7.18 (I2Cm_IRQ_N), U7.19 (GPIO3), U7.26 (GPIO4_USB_P), U7.27 (GPIO5_USB_N), U7.31 (GND), U7.34 (PP5V), U7.35 (PP5V), U7.36 (GPIO7), U7.37 (GPIO6), U7.38 (VIN_3V3), U7.39 (GND_PAD); also elsewhere on the board
unnamed: C2.2, R10.1
unnamed: C4.1, R15.2
unnamed: R5.1, U1.1 (A0)
unnamed: R7.1, U1.2 (A1)
unnamed: R9.1, U1.3 (A2)
unnamed: R17.1, U1.7 (WP)
unnamed: C17.2, U5.19 (BST1)
unnamed: C16.2, U5.12 (BST2)
unnamed: C13.1, R15.1, U5.18 (COMP1)
unnamed: C11.1, R10.2, U5.13 (COMP2)
unnamed: R24.1, U5.2 (EN1), U5.3 (EN2)
unnamed: C3.2, R13.2, R14.1, U5.17 (FB1)
unnamed: C12.2, R6.1, R11.1, U5.14 (FB2)
unnamed: C17.1, L2.2, U5.20 (LX1)
unnamed: C16.1, L1.1, U5.11 (LX2)
unnamed: R23.2, U5.4 (ROSC/SYNC)
unnamed: R12.2, U5.15 (RSET)
unnamed: C28.2, R25.2, R26.1, U5.23 (V7V)
unnamed: R18.2, U6.6 (ADDRSEL)
unnamed: U7.15 (DRAIN), U7.30 (DRAIN), U7.40 (DRAIN_PAD)
VBUS: C33.2, R19.4, TP8.1, U7.23 (VBUS_IN), U7.24 (VBUS_IN), U7.25 (VBUS_IN), U7.32 (VBUS), U7.33 (VBUS)
VCC: C21.2, C24.2, C29.2, C30.2, C31.2, R24.2, TP7.1, U5.9 (VIN2), U5.22 (VIN1), U7.20 (PPHV), U7.21 (PPHV), U7.22 (PPHV)
VUSB: C27.2, TP15.1, U5.7 (SW_OUT); also elsewhere on the board

Notes on the sheet:
7-bit I²C address as target device is 0100000 (0x20)
USB ESD protection
Dual buck for 3.5A@3.3V (M.2 only), 2.5A@5V and 0.5A limited USB +5V
USB PD controller (sink only configuration)
7-bit I²C address is 1010000 (0x50)
Power meter
USB-C jack
I2C address: 0011 101

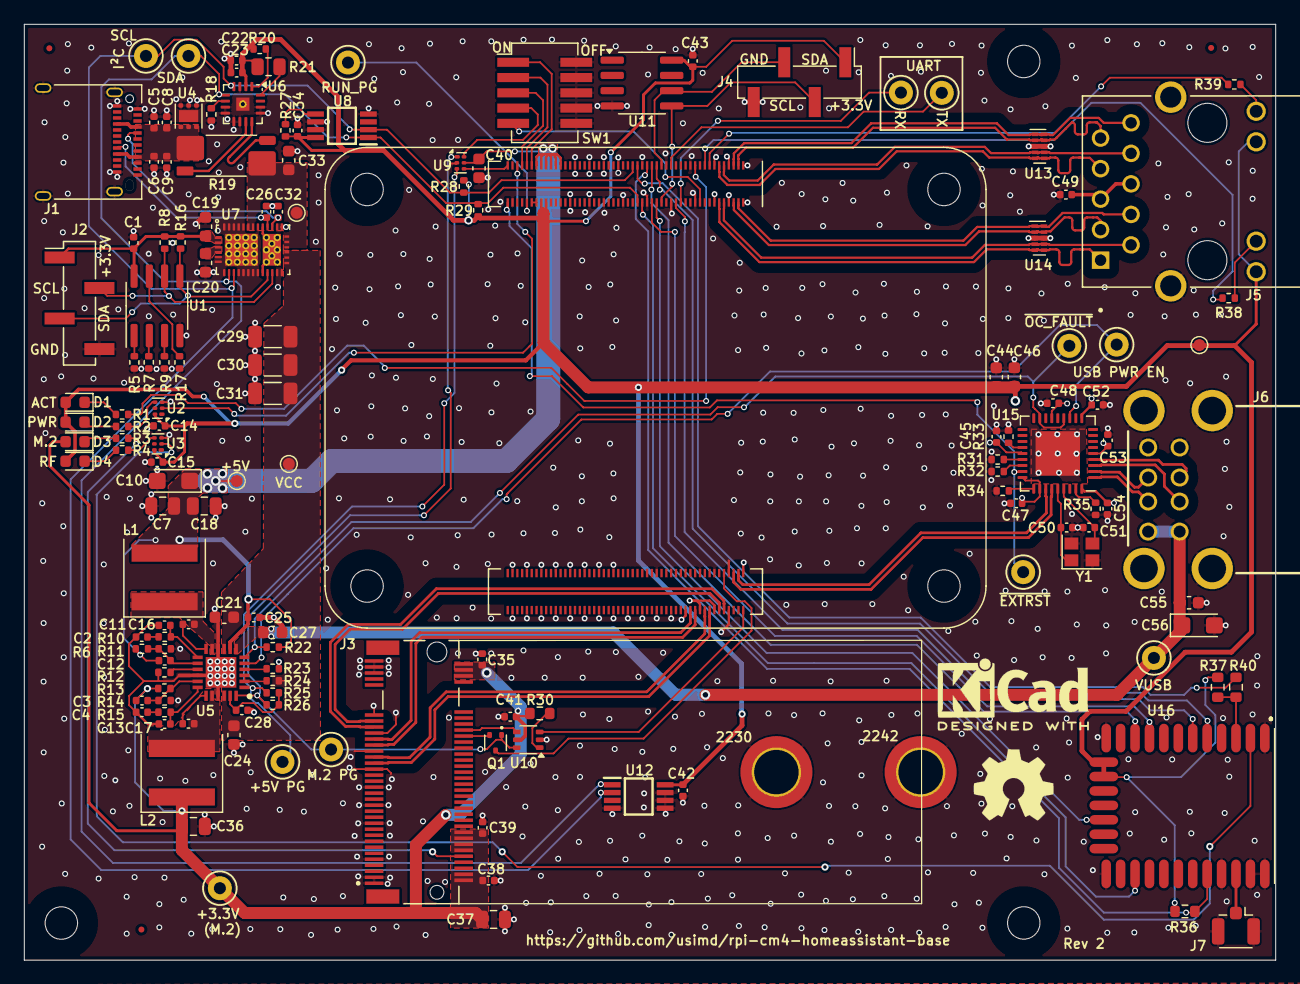
[picture p10: board rpi-cm-ssd.kicad_pcb from above]

Board: 4 copper layers, 104.1 x 77.9 mm, 153 parts (0 on the bottom side), 115 nets.
