usimd/rpi-cm4-homeassistant-base/rpi-cm4-base-carrier/rpi-cm4-base-carrier.kicad_pcb

## KiCad design rpi-cm4-base-carrier/rpi-cm4-base-carrier.kicad_pcb (2024-11-03)

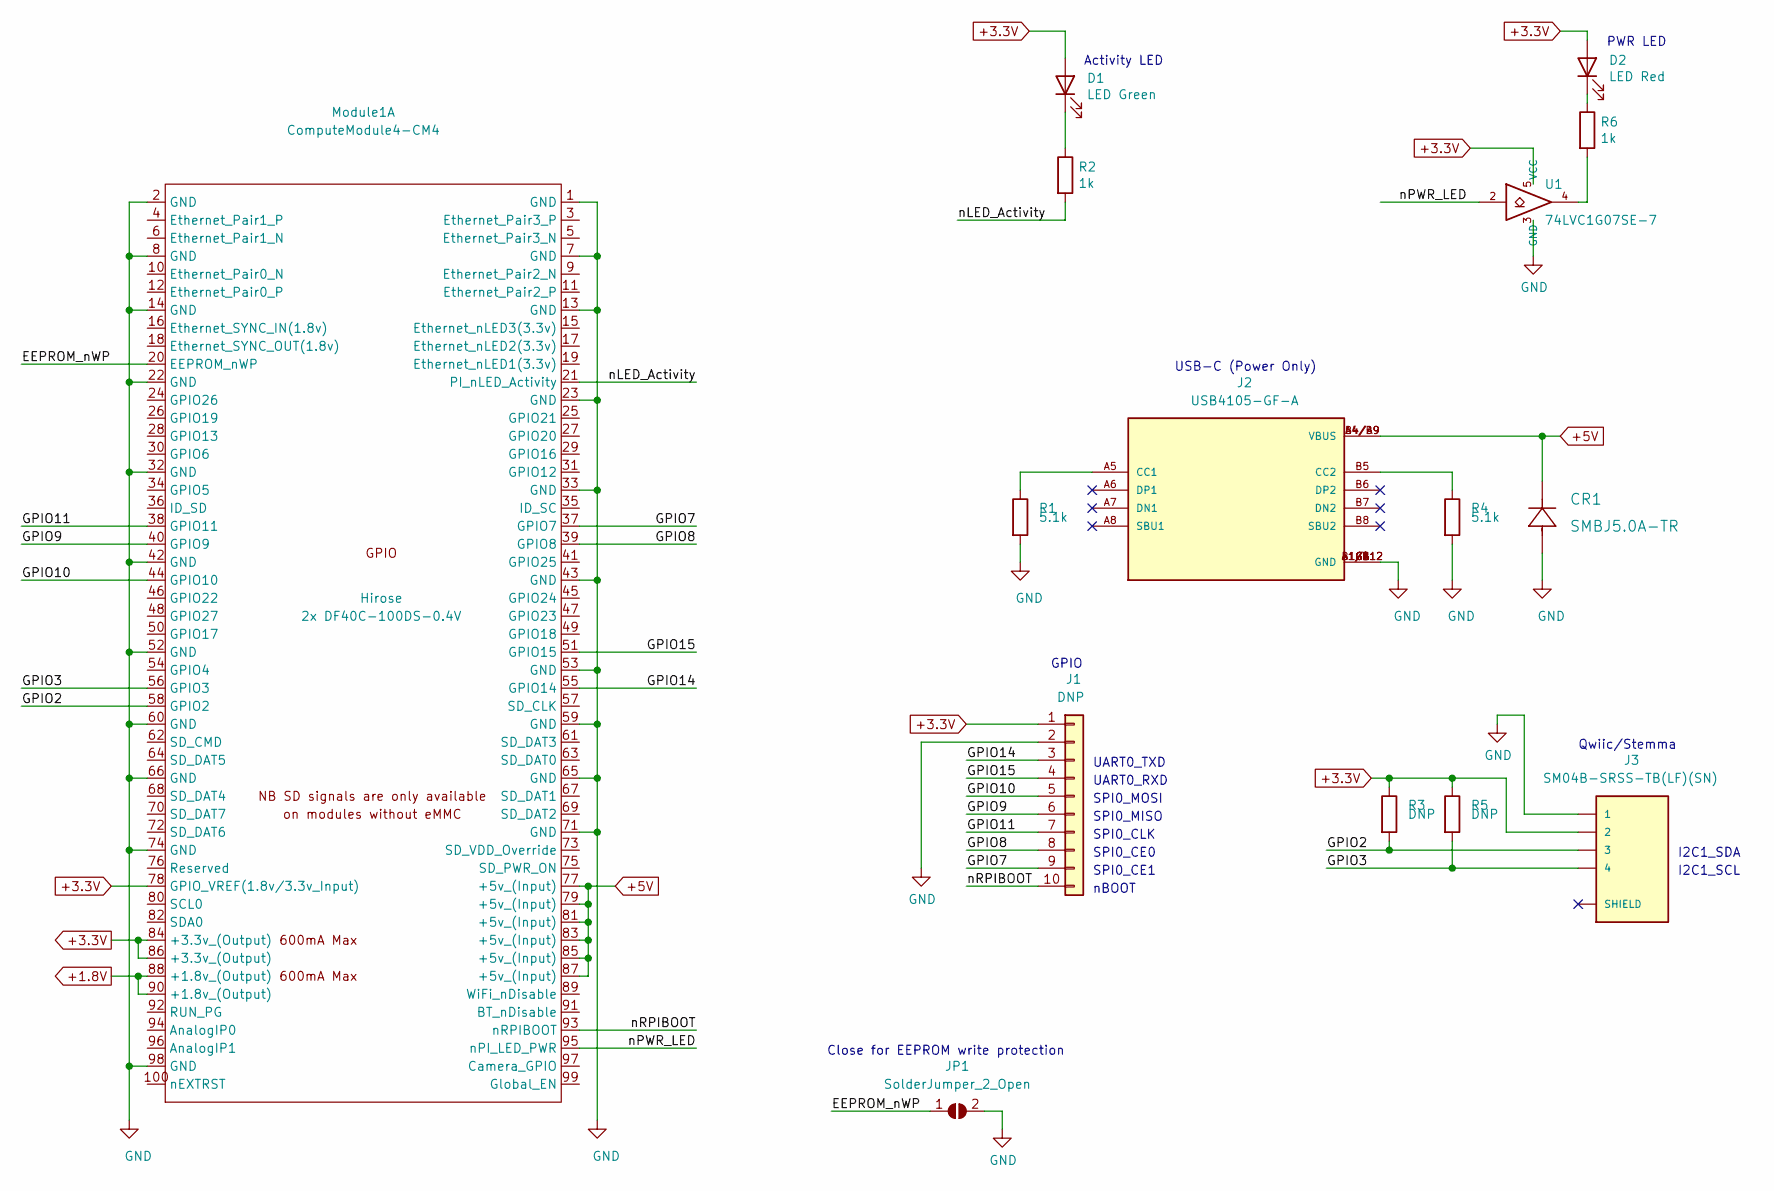
[picture p11: schematic cm4-gpio.kicad_sch, Raspberry Pi Compute Module 4 Base Carrier]

Parts:
CR1: SMBJ5.0A-TR; MPN SMBJ5.0A-TR; Digi-Key_PN 497-3144-1-ND
D1: LED Green; LED_0603_1608Metric; Part Description Green 572nm LED Indication - Discrete 2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; Digi-Key_PN 160-1478-1-ND
D2: LED Red; LED_0603_1608Metric; Part Description Red 620nm LED Indication - Discrete 2.2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; Digi-Key_PN 160-1479-1-ND
J1: DNP; PinHeader_1x10_P2.54mm_Vertical
J2: USB4105-GF-A; GCT_USB4105-GF-A; MPN USB4105-GF-A; Digi-Key_PN 2073-USB4105-GF-ACT-ND
J3: SM04B-SRSS-TB(LF)(SN); JST_SM04B-SRSS-TB(LF)(SN); MPN SM04B-SRSS-TB(LF)(SN); Digi-Key_PN 455-1804-1-ND
JP1: SolderJumper_2_Open; SolderJumper-2_P1.3mm_Open_RoundedPad1.0x1.5mm
Module1: ComputeModule4-CM4; Raspberry-Pi-4-Compute-Module; MPN 2x DF40C-100DS-0.4V; Digi-Key_PN 2x H11615CT-ND
R1, R4: 5.1k; R_0603_1608Metric_Pad0.98x0.95mm_HandSolder; MPN RC0603FR-075K1L; Digi-Key_PN 311-5.10KHRCT-ND
R2, R6: 1k; R_0603_1608Metric_Pad0.98x0.95mm_HandSolder; MPN RC0603FR-071KL; Digi-Key_PN 311-1.00KHRCT-ND
R3, R5: DNP; R_0603_1608Metric_Pad0.98x0.95mm_HandSolder
U1: 74LVC1G07SE-7; SOT-353_SC-70-5; Part Description Buffer, Non-Inverting 1 Element 1 Bit p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; Digi-Key_PN 74LVC1G07SE-7DICT-ND

Connections:
+1.8V: Module1.88 (+1.8v_(Output)), Module1.90 (+1.8v_(Output))
+3.3V: D1.2 (A), D2.2 (A), J1.1, J3.2, Module1.78 (GPIO_VREF(1.8v/3.3v_Input)), Module1.84 (+3.3v_(Output)), Module1.86 (+3.3v_(Output)), R3.1, R5.1, U1.5 (VCC)
+5V: CR1.1, J2.A4/B9 (VBUS), J2.B4/A9 (VBUS), Module1.77 (+5v_(Input)), Module1.79 (+5v_(Input)), Module1.81 (+5v_(Input)), Module1.83 (+5v_(Input)), Module1.85 (+5v_(Input)), Module1.87 (+5v_(Input))
/CM4 GPIO/EEPROM_nWP: JP1.1 (A), Module1.20 (EEPROM_nWP)
/CM4 GPIO/GPIO2: J3.3, Module1.58 (GPIO2), R3.2
/CM4 GPIO/GPIO3: J3.4, Module1.56 (GPIO3), R5.2
/CM4 GPIO/GPIO7: J1.9, Module1.37 (GPIO7)
/CM4 GPIO/GPIO8: J1.8, Module1.39 (GPIO8)
/CM4 GPIO/GPIO9: J1.6, Module1.40 (GPIO9)
/CM4 GPIO/GPIO10: J1.5, Module1.44 (GPIO10)
/CM4 GPIO/GPIO11: J1.7, Module1.38 (GPIO11)
/CM4 GPIO/GPIO14: J1.3, Module1.55 (GPIO14)
/CM4 GPIO/GPIO15: J1.4, Module1.51 (GPIO15)
/CM4 GPIO/nLED_Activity: Module1.21 (PI_nLED_Activity), R2.2
/CM4 GPIO/nPWR_LED: Module1.95 (nPI_LED_PWR), U1.2
/CM4 GPIO/nRPIBOOT: J1.10, Module1.93 (nRPIBOOT)
GND: CR1.2, J1.2, J2.A1/B12 (GND), J2.B1/A12 (GND), J2.G1 (GND), J2.G2 (GND), J2.G3 (GND), J2.G4 (GND), J3.1, JP1.2 (B), Module1.1 (GND), Module1.2 (GND), Module1.7 (GND), Module1.8 (GND), Module1.13 (GND), Module1.14 (GND), Module1.22 (GND), Module1.23 (GND), Module1.32 (GND), Module1.33 (GND), Module1.42 (GND), Module1.43 (GND), Module1.52 (GND), Module1.53 (GND), Module1.59 (GND), Module1.60 (GND), Module1.65 (GND), Module1.66 (GND), Module1.71 (GND), Module1.74 (GND), Module1.98 (GND), R1.2, R4.2, U1.3 (GND); also elsewhere on the board
unnamed: D1.1 (K), R2.1
unnamed: D2.1 (K), R6.1
unnamed: J2.A5 (CC1), R1.1
unnamed: J2.B5 (CC2), R4.1
unnamed: J3.S1 (SHIELD), J3.S2 (SHIELD)
unnamed: R6.2, U1.4

Notes on the sheet:
Close for EEPROM write protection
Activity LED
GPIO
UART0_TXD
UART0_RXD
SPI0_MOSI
SPI0_MISO
SPI0_CLK
SPI0_CE0
SPI0_CE1
nBOOT
USB-C (Power Only)
PWR LED
Qwiic/Stemma
I2C1_SDA
I2C1_SCL

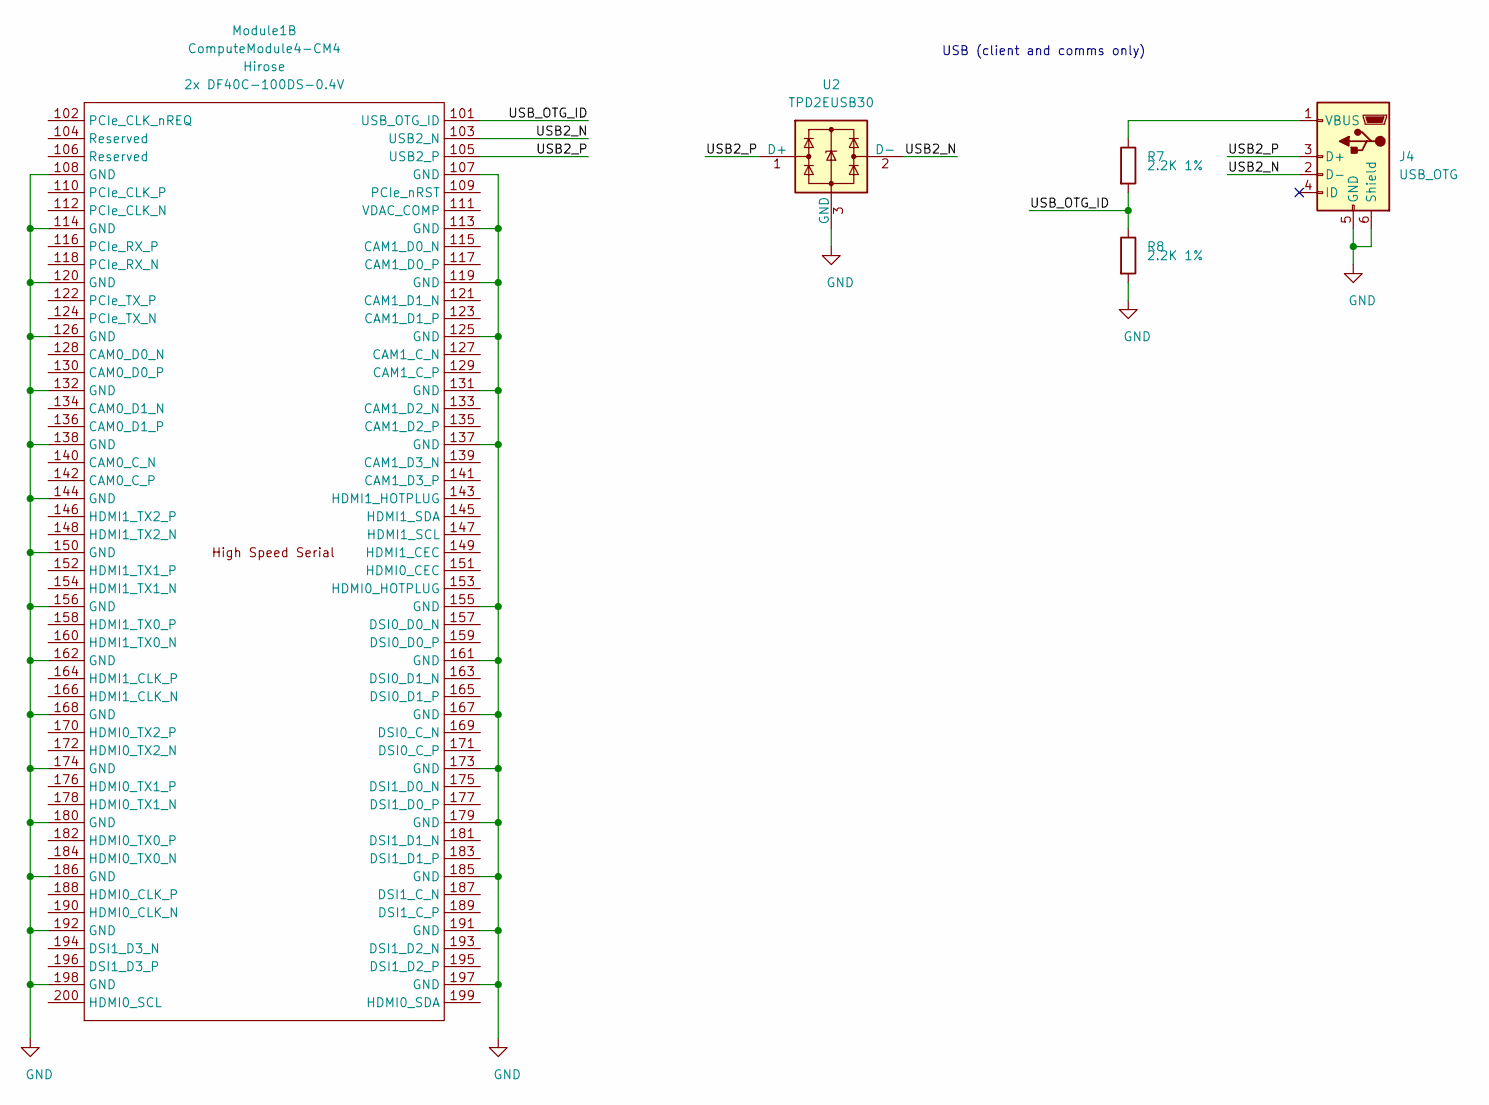
[picture p12: schematic cm4-high-speed.kicad_sch, Raspberry Pi Compute Module 4 Base Carrier]

Parts:
J4: USB_OTG; USB_Micro-B_EDAC_UCON00686; MPN 10103594-0001LF; Digi-Key_PN 609-4050-1-ND
Module1: ComputeModule4-CM4; Raspberry-Pi-4-Compute-Module; Digi-Key_PN 2x H11615CT-ND
R7, R8: 2.2K 1%; R_0603_1608Metric_Pad0.98x0.95mm_HandSolder; MPN RC0603FR-072K2L; Digi-Key_PN 311-2.20KHRCT-ND
U2: TPD2EUSB30; Texas_DRT-3; MPN TPD2EUSB30DRTR; Digi-Key_PN 296-25509-1-ND

Connections:
/CM4 High Speed/USB2_N: J4.2 (D-), Module1.103 (USB2_N), U2.2 (D-)
/CM4 High Speed/USB2_P: J4.3 (D+), Module1.105 (USB2_P), U2.1 (D+)
/CM4 High Speed/USB_OTG_ID: Module1.101 (USB_OTG_ID), R7.2, R8.1
GND: J4.5 (GND), J4.6 (Shield), Module1.107 (GND), Module1.108 (GND), Module1.113 (GND), Module1.114 (GND), Module1.119 (GND), Module1.120 (GND), Module1.125 (GND), Module1.126 (GND), Module1.131 (GND), Module1.132 (GND), Module1.137 (GND), Module1.138 (GND), Module1.144 (GND), Module1.150 (GND), Module1.155 (GND), Module1.156 (GND), Module1.161 (GND), Module1.162 (GND), Module1.167 (GND), Module1.168 (GND), Module1.173 (GND), Module1.174 (GND), Module1.179 (GND), Module1.180 (GND), Module1.185 (GND), Module1.186 (GND), Module1.191 (GND), Module1.192 (GND), Module1.197 (GND), Module1.198 (GND), R8.2, U2.3 (GND); also elsewhere on the board
unnamed: J4.1 (VBUS), R7.1

Notes on the sheet:
USB (client and comms only)

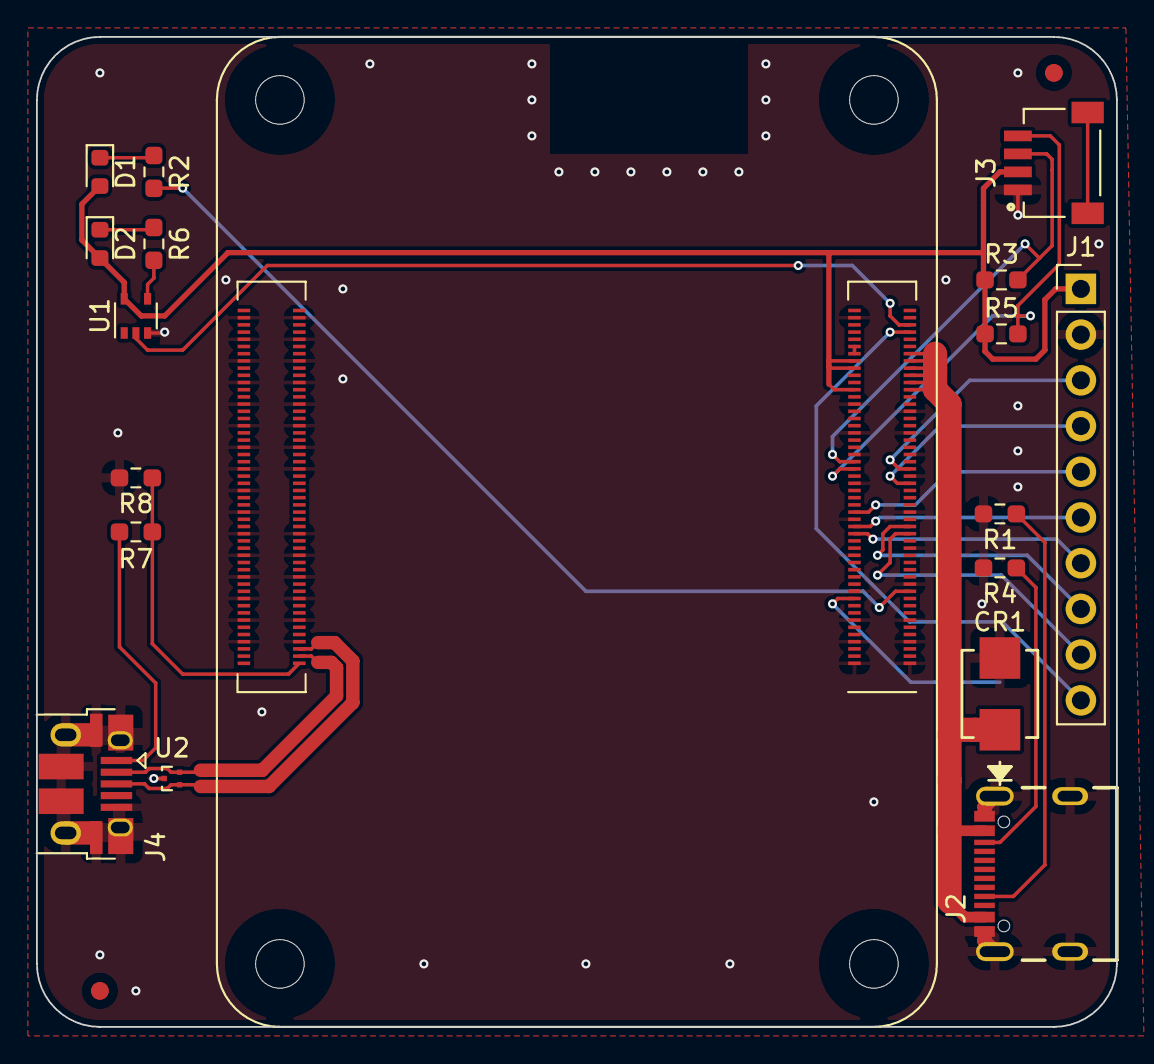
[picture p13: board rpi-cm4-base-carrier.kicad_pcb from above]

Board: 2 copper layers, 60.0 x 55.0 mm, 19 parts (1 on the bottom side), 27 nets.
