usimd/rpi-cm4-homeassistant-base/(commit log)

2022-11-20 Initial import
    [cm4_gpio.kicad_sch, cm4_highspeed.kicad_sch, power.kicad_sch, rpi-cm-ssd.kicad_pcb, rpi-cm-ssd.kicad_sch, sensors.kicad_sch, usb.kicad_sch, wireless.kicad_sch]
2022-12-08 Add bus debug test points
    For easier debugging the I2C and SPI bus are being branched to via test
    pads. Some enhancements to the PD controller are made by connecting PP5V
    to ground. Also corrects the footprint of the energy meter.
    [power.kicad_sch, rpi-cm-ssd.kicad_pcb, rpi-cm-ssd.kicad_sch, sensors.kicad_sch]
2022-12-08 Update readme, add PD controller config
    [rpi-cm-ssd.kicad_sch, sensors.kicad_sch]
2025-01-28 Prep Rev2
    [cm4_gpio.kicad_sch, cm4_highspeed.kicad_sch, power.kicad_sch, rpi-cm-ssd.kicad_pcb, rpi-cm-ssd.kicad_sch, sensors.kicad_sch, usb.kicad_sch, wireless.kicad_sch]
2025-02-02 Rev 2
    [cm4_gpio.kicad_sch, cm4_highspeed.kicad_sch, power.kicad_sch, rpi-cm-ssd.kicad_pcb, rpi-cm-ssd.kicad_sch, sensors.kicad_sch, usb.kicad_sch, wireless.kicad_sch]
